olliebuckthorpe/inverted-pendulum/hardware/cad/LAYOUT.md

# Rig layout and CAD notes (PLAN 2.2)

Parametric CAD in `pendulum_cad.py` (CadQuery). `uv run python pendulum_cad.py` writes STEP + STL to `out/`;
`uv run python preview.py` renders `out/assembly_preview.png`. Change a number in `P`, re-run, re-print.

## Rig layout (decided 25 Sep: desk-edge beam)

- The rail is bolted to the **front face of a stiff beam** (e.g. 1.2 m of 18 mm plywood on edge) that is
  G-clamped along the **front edge of the desk**. The rods hang over the edge: the single needs 30 cm below
  the pivot and the double (both hanging) 50 cm; a ~72 cm desk clears both.
- The pendulum shaft comes straight out of the cart toward the room; **the rod swings in the frontmost plane
  of the rig** (Y ≈ 47 mm). Nothing else may be in front of Y ≈ 40 mm anywhere the rods can reach: at the rail
  ends the double's rods sweep up to 50 cm around the pivot.
- **So the motor and idler sit behind that plane:** the motor body goes behind the beam (end blocks overhang
  the beam ends), with the pulley in the belt plane. The belt runs just below the rail, between the beam and
  the carriage (Y ≈ −9 … −3 mm).
- Safety: keep legs and hands out of the swing zone in front of the desk; the E-stop must be reachable
  without reaching past the rods.

## Coordinates

X along the rail, Z up, Y out of the beam toward the room. Y = −13 beam face (MGN12H H = 13 mm);
Y = 0 carriage top face; Z = 0 rail centreline; the shaft is at Z = +34 mm.

## Parts so far (v1, untested)

| Part | Size (mm) | Est. print | Notes |
|---|---|---|---|
| cart | 70 × 49 × 84 | ~28 g | Plate on 12 mm pads on the MGN12H's 20 × 20 M3 pattern (M3 × **20**: engages 3.0 of the 3.5 mm thread). Boss holds two 608s ~13 mm apart. Ridged ledge for the belt below the carriage |
| belt_clamp | 40 × 17 × 3 | ~2 g | Squeezes the upper belt strand against the ledge; 2 × M3 × 12 self-tapping |
| sensor_mount | 36 × 14 × 36 | ~3 g | On 4 posts behind the plate; AS5047P board behind it, chip through a 14 mm window; slots ±2 mm |
| magnet_cap | Ø11 × 12 | ~1 g | Push-fit on the shaft's back end; holds the magnet 3 mm off the steel shaft |
| rod_hub | 36 × 18 × 14 | ~3 g | Split clamp on the shaft + socket for the 8 mm tube, M3 pinch screws |

**Steel shaft: cut to 49 mm.** The script prints this and the sensor gap; both follow from the parameters.

**Estimated cart mass ≈ 145 g** (printed ~35 g + MGN12H 54 g + two 608s ~24 g + 49 mm of 8 mm steel ~19 g +
sensor board and screws ~13 g). The sim assumed 400 g, and the AI's domain randomisation (±15%) never reaches
145 g: update `sim/params.yaml` cart.mass before the final training (weigh the real parts in PLAN 2.2).

## Why some choices were made

- **Sensor behind the plate:** the front of the shaft carries the rod, which swings a full circle, so no
  bracket can reach the front end. The back end sits in free space above the carriage.
- **Magnet cap (precaution):** the shaft is silver steel, which is magnetic and may distort the magnet's
  field; the AS5047P datasheet doesn't cover shaft material. The cap holds the magnet 3 mm off the steel.
  Check in PLAN 2.4 (smooth 0–360° reading, noise); set `cap_spacer` to 0 if it proves unnecessary.
- **Taller pads (M3 × 20):** gives 10.7 mm behind the sensor bracket for the board and its pins.

## Check when the parts arrive (before printing the final version)

- [ ] AS5047P adapter board: outline, hole positions, thickness, chip height, and header direction
      (update `sensor_mount` if the ±2 mm slots don't cover it).
- [ ] **Print `out/fit_test.stl` first** (≈ 14 g, ~30–40 min): three 608 seats and three 8 mm shaft bores at
      radial clearance 0.10 / 0.15 / 0.20 mm, marked with 1 / 2 / 3 notches. Pick the tightest seat a bearing
      still presses into by hand and the tightest bore the shaft turns in; set `fit` in `P` (default 0.15 mm)
      and re-export before printing the cart, rod hub and magnet cap.
- [ ] Measure the GT2 belt thickness; tune `belt_t`.
- [ ] PLAN 2.2 "done when": the cart slides the full rail by hand without binding, the shaft spins freely in
      both bearings, the magnet sits centred on the sensor.

## End blocks and the safety stop (added 25 Sep)

| Part | Est. print | Notes |
|---|---|---|
| motor_block | ~17 g | +X end. Flange on the beam's end face + tab on its back face (4 wood screws). The Pololu 37D bolts to the plate's back, shaft through toward the room; **12 holes on the Ø31 circle** so the motor fits either hexagon orientation; **M3 screws may enter the gearbox only 3.0 mm** (Pololu drawing). Gearbox centre 7 mm outboard of the shaft; motor body behind the beam's plane, beyond its end |
| idler_block | ~20 g | −X end. Fork holding the 20T idler on an M5 bolt in 14 mm slots: pull outward to tension the belt, tighten; M3 push screw for fine adjustment |
| end_ramp_right / _left | ~33 g each | Foot on the beam face below both belt strands, arm forward under the cart, upright in front of the cart plate (Y 35–40, behind the rod at Y ≈ 43.5). The ramp rises 3 mm from X = ±350 and stays high to the bumper |
| switch_carrier | ~5 g | On the cart plate's front face below the boss: two roller micro switches in series, mirrored so the rollers sit at ±7 mm; slotted to set a 2 mm press |
| bumper_right / _left | ~2 g each | **Print in TPU.** Hollow blocks at X = ±480 in the carriage's path: the last resort |

**Why the end-stops ride on the cart:** a fixed end-stop hit head-on has ~2 mm of overtravel, but after tripping
the cart keeps braking for up to ~118 mm and would crush it. On the ramps, the rollers are pushed sideways
and **stay pressed** while the cart brakes; push the cart back by hand to reset. The switch wires join the
sensor cable to the cart.

**Checked by `clearance.py`** (cart at 0, ±325, ±340, ±355, ±457 mm; rod hanging, horizontal both ways,
upright): 0 collisions; switches released at ±325/±340 (the swing-ups use ≤ ±325), pressed at ±355 and
beyond, first trip ≈ ±348 mm. The only contacts are the intended ones (carriage on rail, grip ridges in
the belt teeth). Previews: `out/ends_preview.png`.

**Frame constraint:** the motor's underside is ~55 mm below the rail centre, so keep the beam's base / the
desk ≥ 60 mm below the rail centre in the motor zone. Beam clamps: ordinary G-clamps (nothing to print).

## Still to design

E-stop enclosure (depends on the switch bought), a guide for the cable to the cart.

⚠️ Measure on arrival: micro switch body, holes and lever height; 30T pulley hub; 20T idler width.

Sources: HIWIN MG-series catalogue (MGN12H: W 27, B 20, C 20, L 45.4, H 13, M3 × 3.5, 0.054 kg; MGN12 rail
WR 12, HR 8, P 25): https://hiwin.co.uk/wp-content/uploads/2017/05/CRD-Hiwin-Linear-guides-MG-series.pdf ·
Pololu #4757 dimensions: https://www.pololu.com/product/4757
