olliebuckthorpe/inverted-pendulum/hardware/cad/out/ends_preview.png

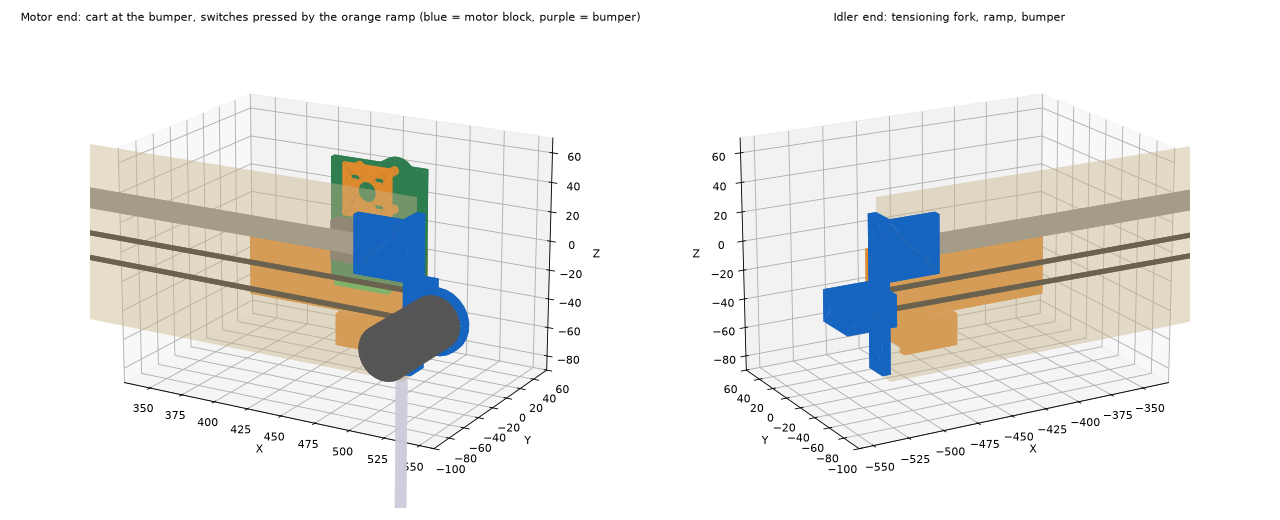
hardware/cad/out/ends_preview.png
