olliebuckthorpe/inverted-pendulum/sim/plots/1.2-fall-from-upright.png

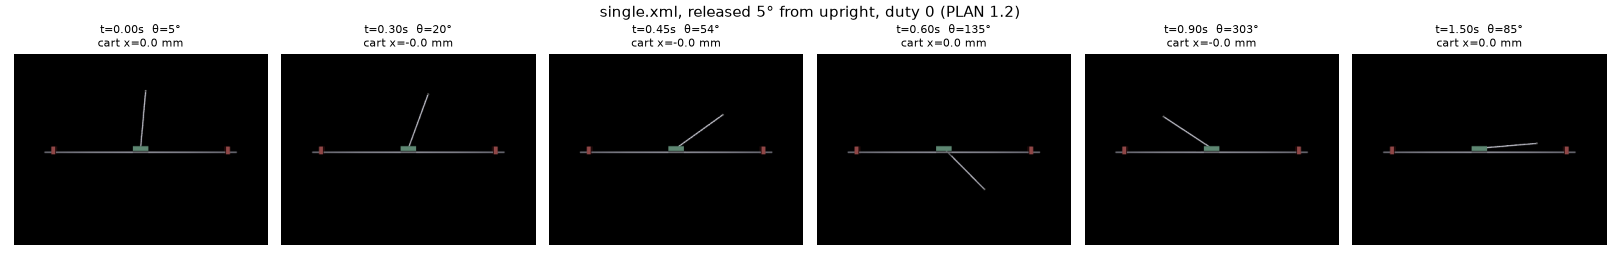
sim/plots/1.2-fall-from-upright.png
