olliebuckthorpe/inverted-pendulum/sim/plots/1.4-lqr-balance.png

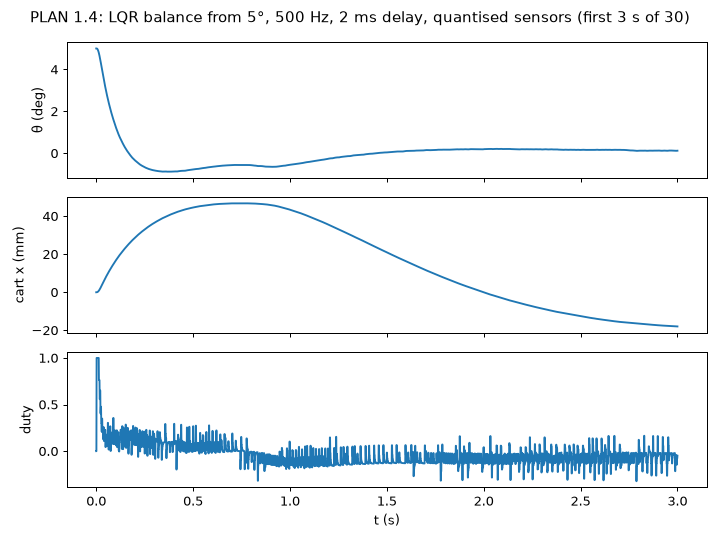
sim/plots/1.4-lqr-balance.png
