olliebuckthorpe/inverted-pendulum/sim/plots/1.5-swingup.png

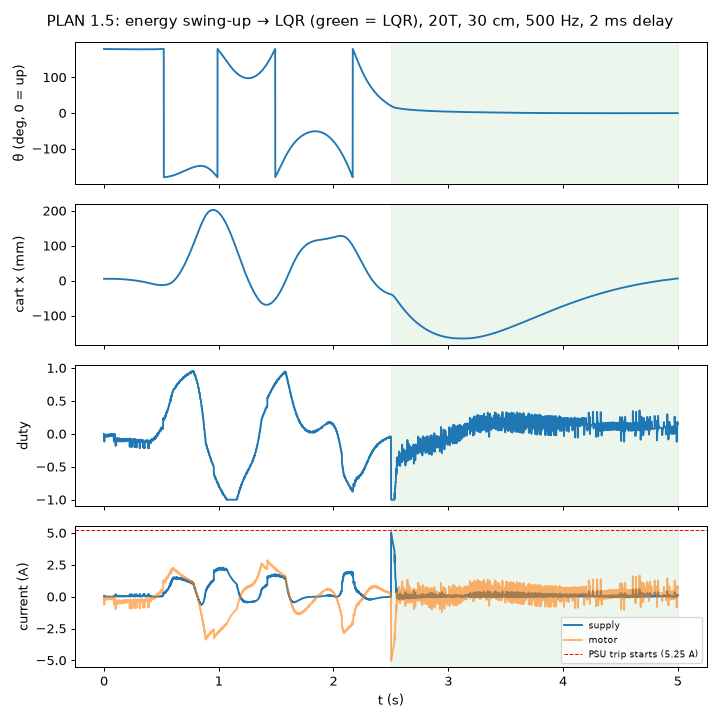
sim/plots/1.5-swingup.png
