olliebuckthorpe/inverted-pendulum/sim/plots/q2-swingup-20T-vs-30T.png

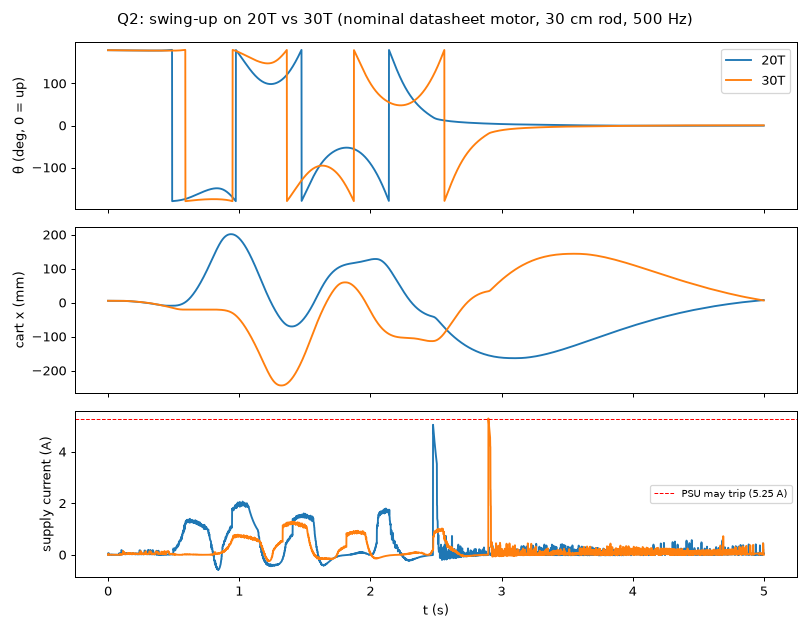
sim/plots/q2-swingup-20T-vs-30T.png
