olliebuckthorpe/inverted-pendulum/sim/plots/sim-phase-single-summary.png

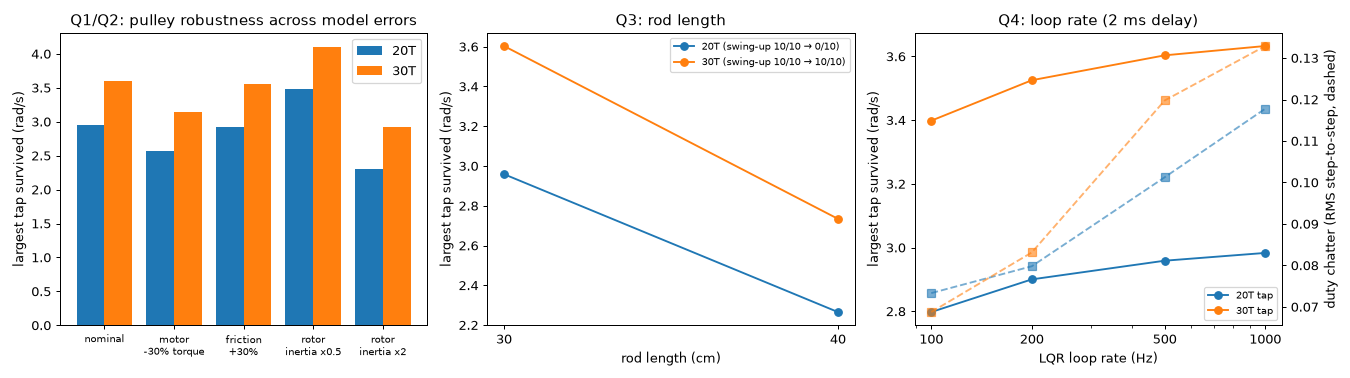
sim/plots/sim-phase-single-summary.png
