olliebuckthorpe/inverted-pendulum/hardware/cad/out/cart.step

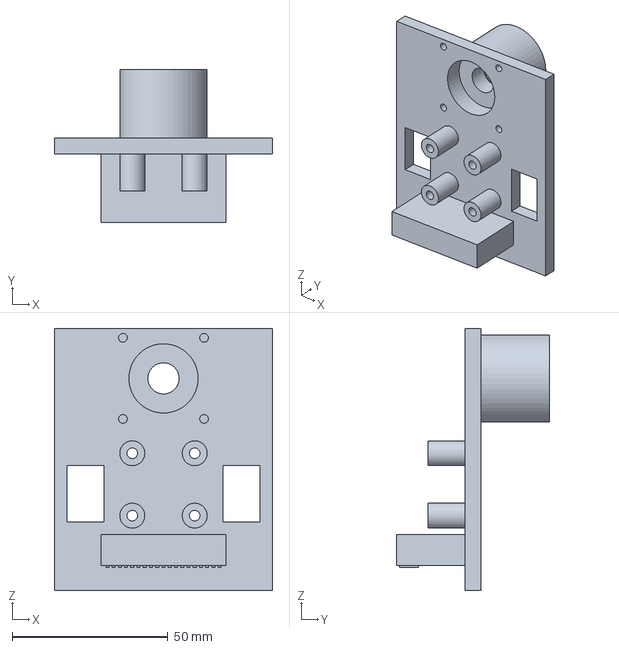
[picture p7: CAD file, 2026-10-05]
hardware/cad/out/cart.step
70.0 x 49.0 x 84.0 mm
