olliebuckthorpe/inverted-pendulum/hardware/cad/out/rod_hub.step

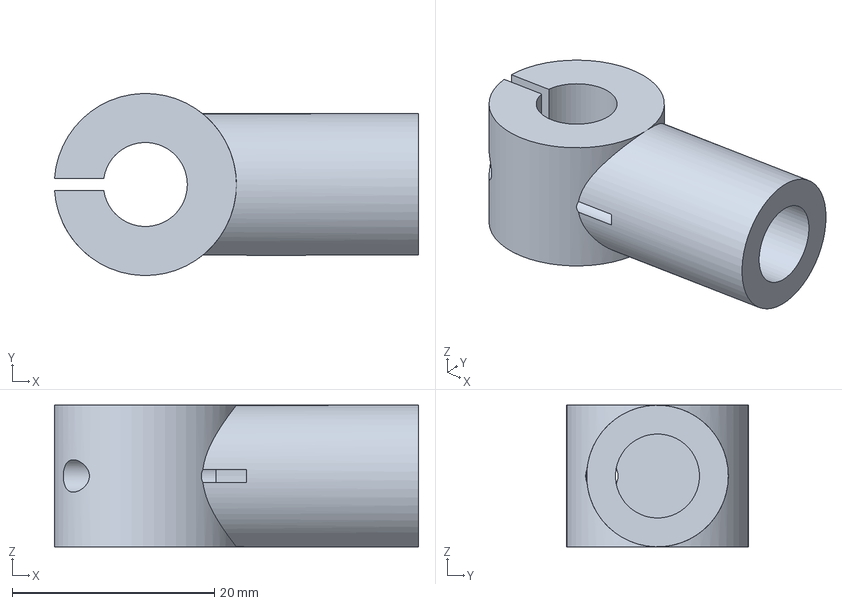
[picture p8: CAD file, 2026-10-05]
hardware/cad/out/rod_hub.step
36.0 x 18.0 x 14.0 mm
