olliebuckthorpe/inverted-pendulum/hardware/cad/out/magnet_cap.step

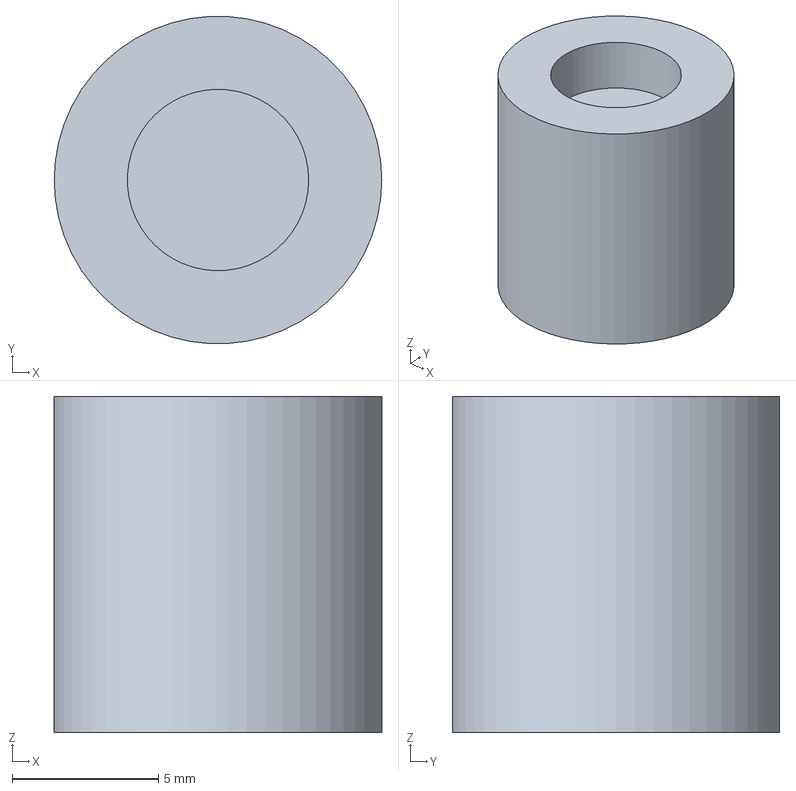
[picture p9: CAD file, 2026-10-05]
hardware/cad/out/magnet_cap.step
11.2 x 11.2 x 11.5 mm
