olliebuckthorpe/inverted-pendulum/hardware/cad/out/fit_test.step

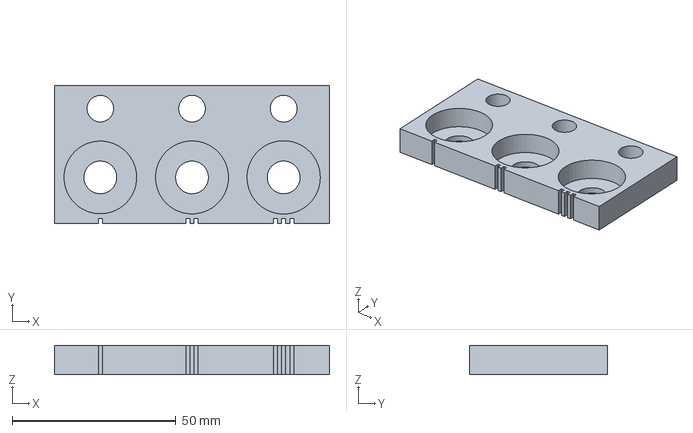
[picture p10: CAD file, 2026-10-05]
hardware/cad/out/fit_test.step
84.0 x 42.0 x 9.00 mm
