olliebuckthorpe/inverted-pendulum/hardware/cad/out/end_ramp_left.step

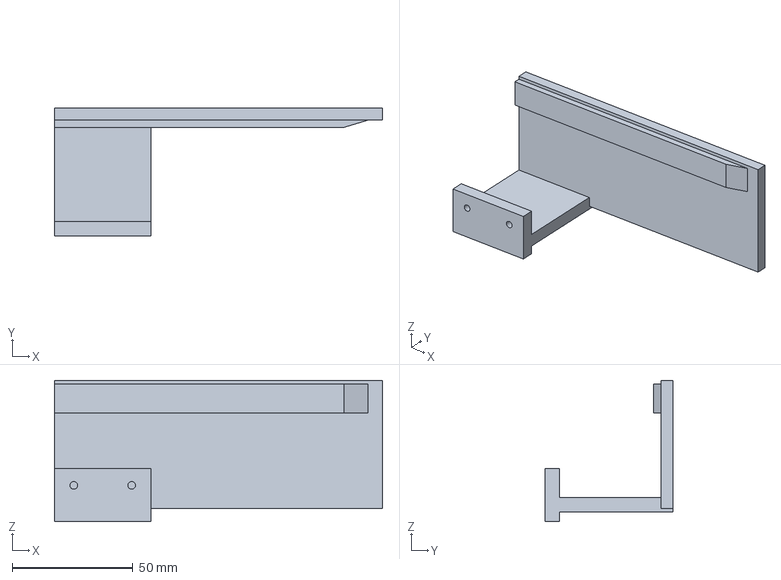
[picture p11: CAD file, 2026-09-25]
hardware/cad/out/end_ramp_left.step
136.0 x 53.0 x 58.5 mm
