olliebuckthorpe/inverted-pendulum/hardware/cad/out/bumper_right.step

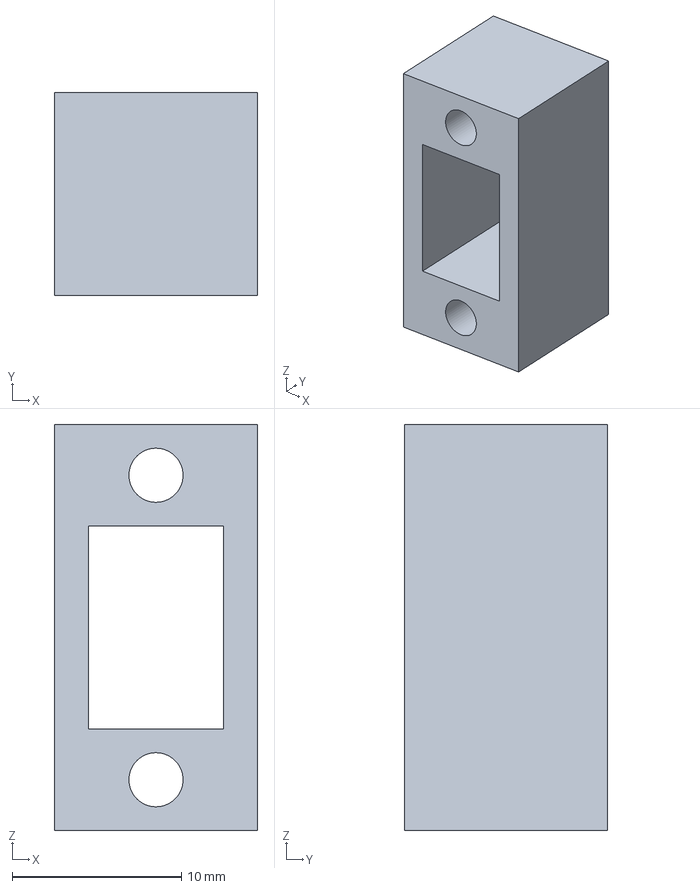
[picture p12: CAD file, 2026-09-25]
hardware/cad/out/bumper_right.step
12.0 x 12.0 x 24.0 mm
