olliebuckthorpe/inverted-pendulum/hardware/cad/out/switch_carrier.step

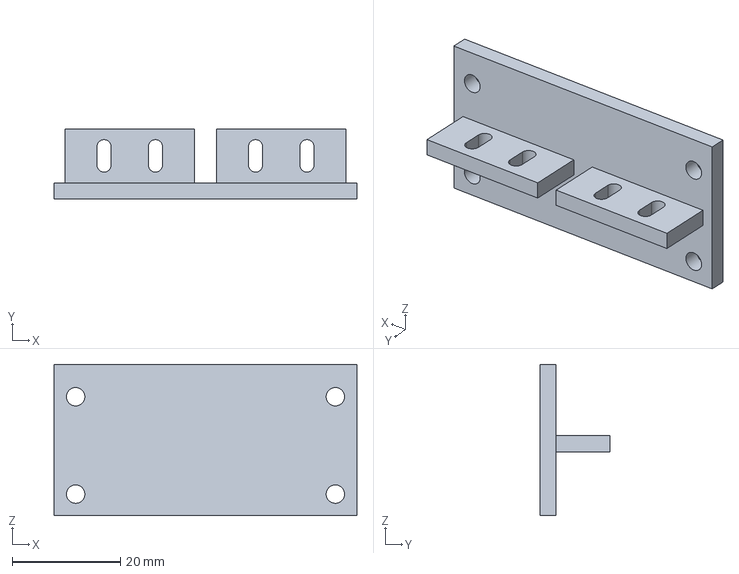
[picture p13: CAD file, 2026-09-25]
hardware/cad/out/switch_carrier.step
56.0 x 13.0 x 28.0 mm
