olliebuckthorpe/inverted-pendulum/hardware/cad/out/motor_block.step

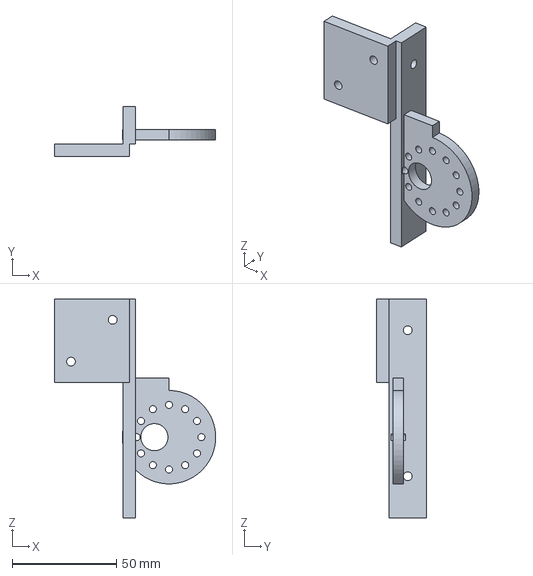
[picture p14: CAD file, 2026-09-25]
hardware/cad/out/motor_block.step
77.4 x 24.0 x 105.0 mm
