olliebuckthorpe/inverted-pendulum/hardware/cad/out/belt_clamp.step

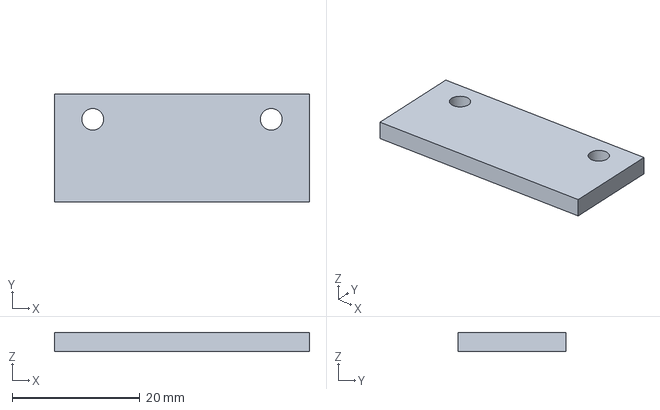
[picture p15: CAD file, 2026-09-25]
hardware/cad/out/belt_clamp.step
40.0 x 17.0 x 3.00 mm
