olliebuckthorpe/inverted-pendulum/hardware/cad/out/sensor_mount.step

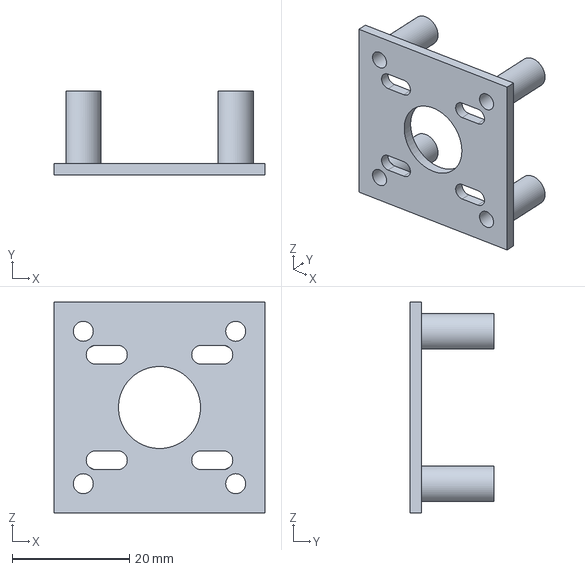
[picture p16: CAD file, 2026-09-25]
hardware/cad/out/sensor_mount.step
36.0 x 14.3 x 36.0 mm
