olliebuckthorpe/inverted-pendulum/hardware/cad/out/idler_block.step

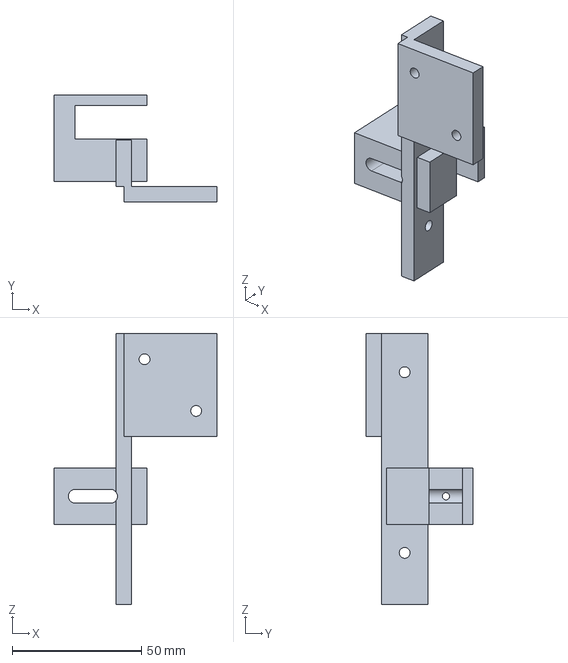
[picture p17: CAD file, 2026-09-25]
hardware/cad/out/idler_block.step
63.0 x 41.5 x 105.0 mm
