olliebuckthorpe/inverted-pendulum/(list of files, cad)

Other CAD files:
hardware/cad/out/cart_print.step
hardware/cad/out/bumper_left.step
hardware/cad/out/end_ramp_right.step
hardware/cad/out/belt_clamp.stl
hardware/cad/out/bumper_left.stl
hardware/cad/out/bumper_right.stl
hardware/cad/out/cart.stl
hardware/cad/out/cart_print.stl
hardware/cad/out/end_ramp_left.stl
hardware/cad/out/end_ramp_right.stl
hardware/cad/out/fit_test.stl
hardware/cad/out/idler_block.stl
hardware/cad/out/magnet_cap.stl
hardware/cad/out/motor_block.stl
hardware/cad/out/rod_hub.stl
hardware/cad/out/sensor_mount.stl
hardware/cad/out/switch_carrier.stl
