olliebuckthorpe/inverted-pendulum/hardware/cad/out/assembly_preview.png

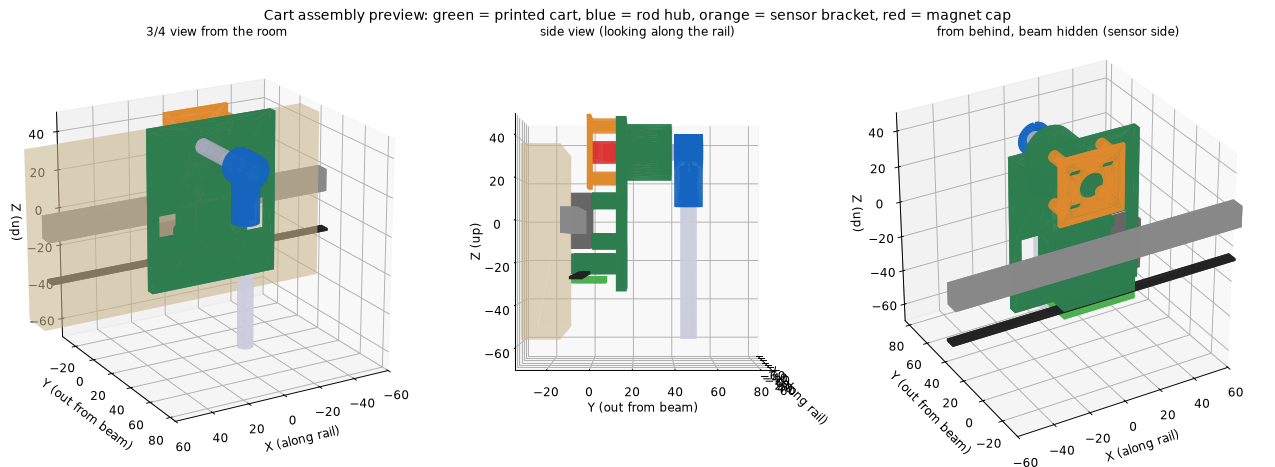
hardware/cad/out/assembly_preview.png
