olliebuckthorpe/inverted-pendulum/sim/RESULTS-sim-phase.md

# Sim phase results (PLAN 1.6), 24 Sep 2026

The sim is **built from datasheets plus guesses** (listed at the end). It can show that something clearly
won't work; it can't prove that something will (SPEC §11). Every number below will move after system ID
(Phase 4).

**Rig simulated:** MuJoCo at 1 kHz. The motor model comes from the Pololu 37D datasheet, including the rotor's
reflected inertia. There's a 2 ms control delay, quantised sensors (400-count motor encoder, 14-bit angle),
and velocities from filtered differencing, as the Pico will do. Code and tests are in `sim/`
(`uv run pytest`: 18 tests).

## Answers at a glance

| # | Question | Answer | Confidence |
|---|---|---|---|
| 1 | Is the Pololu 37D 6.3:1 12 V strong enough? | **Yes**: single swing-up 10/10 on both pulleys, including with 30% less torque, 30% more friction, and rotor inertia ×0.5 or ×2 | Good for "not clearly too weak"; hardware must confirm |
| 2 | 20T or 30T pulley? | **30T (chosen by Ollie, 24 Sep)**: +22% bigger tap survived, better in every model-error case, faster swing-up | Good; driven by rotor inertia, which is estimated |
| 3 | 30 cm or 40 cm rod? | **Keep 30 cm**: 40 cm is worse on both pulleys, and on 20T it can't swing up at all | Good |
| 4 | Loop rate? | **500 Hz for the single** (1 kHz gains ≤ 3% but doubles command chatter); **1 kHz available for the double's swing-up** (more tracking margin) | Medium: depends on the real delay and sensor noise |
| 5 | Double layout? | **30 cm aluminium bottom (rod 1) + 20 cm carbon top**; swing-up 10/10 at 500 Hz and 1 kHz in sim | Medium: very sensitive to the double's own masses and friction |
| 6 | Is the 12 V 5 A PSU enough? | **Yes, with a firmware current limit**: every swing-up, single and double, still succeeds with the supply capped at 5 A | Medium: the limiter needs the fitted motor constants |

**To order now (Ollie):** Pololu 37D 6.3:1 12 V with 64 CPR encoder (#4757), and the Mean Well GST60A12-P1J
from RS. Both pulleys are already on the list.

---

## 1. Motor adequacy

Energy swing-up → LQR, 10 randomised starts per case, 500 Hz, 2 ms delay (`q2_pulley.py`):

| World | 20T swing-up | 30T swing-up |
|---|---|---|
| Datasheet (nominal) | 10/10 | 10/10 |
| Motor −30% torque | 10/10 | 10/10 |
| Friction +30% | 10/10 | 10/10 |
| Rotor inertia ×0.5 | 10/10 | 10/10 |
| Rotor inertia ×2 | 10/10 | 10/10 |

The fallback (the 24 V motor) is not needed on this evidence.

## 2. Pulley: 30T (chosen)

Plot: `plots/sim-phase-single-summary.png` (left); swing-up traces: `plots/q2-swingup-20T-vs-30T.png`.

| | 20T | 30T |
|---|---|---|
| Largest tap LQR survives, nominal | 2.96 rad/s | **3.60 rad/s** |
| … with motor −30% | 2.57 | **3.14** |
| … with rotor inertia ×2 | 2.30 | **2.92** |
| Swing-up time when allowed to push harder (a_max 10 m/s²) | 2.34 s | **1.68 s** |
| Share of swing-up at full duty | up to 29% | 11–18% |
| Rail used (of ±400 mm) | ≤ 250 mm | ≤ 325 mm |
| Cart resolution | 0.10 mm/count | 0.15 mm/count |

**Why the lower-force pulley wins:** the motor's rotor spins 6.3× faster than the gearbox output, so to the
cart it feels like extra mass of J·N²/r². That's **~2.9 kg on 20T but ~1.3 kg on 30T**, against a 0.4 kg
cart. The 30T's bigger radius cuts that phantom mass by 2.25×, which more than makes up for its 1.5× lower
force. The rotor inertia J isn't published; it's estimated from comparable motors, which is why it was swept
from ×0.5 to ×2. The 30T wins at every value.

**Costs of 30T:** it uses more rail during swing-up (75 mm margin left), a faster cart hits the end-stops
harder (relevant to the safety checklist), and the position resolution is slightly coarser (still well under
a millimetre).

## 3. Rod length: keep 30 cm

| | 30 cm | 40 cm |
|---|---|---|
| 30T: swing-up / largest tap | 10/10, 3.60 rad/s | 10/10, 2.73 rad/s |
| 20T: swing-up / largest tap | 10/10, 2.96 rad/s | **0/10** (runs into the rail), 2.27 rad/s |

A longer rod falls more slowly, but it needs more energy and more cart travel to swing up. (Caveat: the same
tap in rad/s is a slightly bigger push on a longer rod. The 20T/40 cm swing-up failure settles it anyway.)

## 4. Loop rate: 500 Hz

The single (LQR with a 2 ms delay):

| Rate | 30T largest tap | 20T largest tap | Swing-up | Command chatter (30T)* |
|---|---|---|---|---|
| 100 Hz | 3.40 | 2.80 | 10/10 | 0.069 |
| 200 Hz | 3.53 | 2.90 | 10/10 | 0.083 |
| 500 Hz | 3.60 | 2.96 | 10/10 | 0.120 |
| 1000 Hz | 3.63 | 2.98 | 10/10 | 0.133 |

\*RMS change in duty between consecutive commands while recovering from 5°. At higher rates, one sensor count
divided by a shorter time looks like a bigger velocity jump, so the motor gets buzzier.

The plan's rule is "the lowest rate that keeps full robustness, ×2 for margin". 200 Hz keeps 98% of the
robustness, so ×2 gives ~400 Hz; **500 Hz** is chosen (it's also the spec's default). For the double, balance is
equally good at both rates, but the swing-up has more margin at 1 kHz (§5), so keep the spec's ~1 kHz for the
double. The AI policy decides at 50–100 Hz as the spec says; that's a Phase 5 choice.

## 5. Double layout (balance and swing-up)

**Recommendation: bottom rod = the single's 30 cm aluminium rod, top rod = 20 cm carbon ("30/20").** It's the
only 30T layout whose swing-up tracks 10/10 at both 500 Hz and 1 kHz. It reuses rod 1, and its balance is
among the strongest.

All with the supply capped at 5 A, 10 randomised starts each (`q5_double.py`, `double_trajopt.py`):

| Layout (bottom/top, cm) | Balance: largest tap (rad/s) | Swing-up plan | Tracked 1 kHz | Tracked 500 Hz |
|---|---|---|---|---|
| **30T 30/20** | 0.88 | 2.46 s | **10/10** | **10/10** |
| 30T 30/30 | 0.74 | 2.05 s (planned within ±300 mm) | 10/10 | 9/10 |
| 30T 34/20 | 0.82 | 1.91 s (±300 mm) | 10/10 | 1/10 |
| 30T 20/30 | 0.87 | 1.88 s | 0/10 (runs into the rail) | 0/10 |
| 20T 30/20, 20T 34/20 | 0.84, 0.78 | none found | – | – |
| 20T 30/30, 20T 20/30 | 0.73, 0.91 | 2.54 s, 2.26 s | 10/10, 10/10 | 10/10, 10/10 |

The first plans were allowed to use ±350 mm of rail, and the fastest ones left the tracker no room to correct.
Re-planning within ±300 mm fixed two of the three.

**How much model error the 30T 30/20 swing-up tolerates** (planned on the nominal model, flown on a "wrong"
rig at 500 Hz, 5 randomised starts each):

| Survives (5/5) | Fails |
|---|---|
| cart mass ±20%, rotor inertia ×0.7, motor Kt −10%, rail friction ×2, 4 ms delay, 12-bit angles (0.09°) | rotor inertia ×1.4 (0/5), Kt −20% (0/5), joint-2 mass ±25% (1/5, 0/5), top-rod mass +20% (0/5), joint friction ×5 (0/5), **0.05° random angle noise** (0/5; balance survives it) |

So the hardware swing-up needs: **masses weighed** (easy, and they're the most sensitive), **motor constants and
joint friction from system ID**, a **low-friction** joint 1 (slip ring friction adds directly to joint
friction), and a **state estimator** (Kalman filter) rather than plain differencing, because the sensor noise
isn't measured yet (PLAN 2.4).

**Loop rate for the double:** balance is equally good at 500 Hz and 1 kHz. Swing-up tracking has more margin
at 1 kHz (34/20 only works there), so **the firmware should support 1 kHz for the double**; the single stays at
500 Hz.

## 6. Power supply: keep the 5 A unit, add a firmware current limit

- Uncapped, a single swing-up peaks at **5.1 A (20T) / 5.5 A (30T)** from the supply, and up to 7 A when the
  controller pushes harder. The double's tracking corrections reach **9.6 A**. The GST60A12 trips into hiccup
  mode at 105–150% of 60 W (≈ 5.25–7.5 A), so **an unprotected rig would sometimes drop out mid-swing**.
- With the supply current **capped at 5 A in software**, every swing-up still succeeds: the single on both
  pulleys (10/10), and the double on its working layouts (10/10). RMS current is only ~0.4–1.1 A, so the PSU
  isn't working hard on average.
- **Firmware requirement (for Phase 2.6 / 3.4):** port `motor.cap_duty_for_supply` to the Pico. From the duty
  cycle and the measured cart speed, it limits the duty so that supply current = duty × (V·duty − Ke·ω)/R stays
  ≤ the limit. Both controllers go through it, so the comparison stays fair. **Use 4.5 A until Phase 4 fits
  the real R and Ke**, then 5.0 A.
- Keep the 7.5 A fuse. The bulk capacitor for regenerative braking (PLAN 2.1) also absorbs millisecond
  peaks.

## Double swing-up (added at Ollie's request, 24 Sep)

Classical method: **trajectory optimisation** (CasADi + IPOPT, direct collocation) finds a motor-command plan
from both-hanging to both-upright, within duty ≤ 0.8, cart ≤ ±350 mm and supply ≤ 5 A. **Time-varying LQR**
then follows the plan and **hands over** to the double's balance LQR at the top. The equations of motion
were derived by hand (sympy/Lagrange) and match MuJoCo to 1 part in a million (`tests/test_double_eom.py`).
Video: `videos/double-30T_30-20-seed0.mp4` (regenerate with `uv run python watch.py double --video`).

**What this does and doesn't show:**
- It shows that **the motor, rail and 5 A supply are physically enough** for a double swing-up, and that a
  classical controller can follow a plan and hand over to balance despite delay, quantisation and unmodelled
  friction.
- It's **one rehearsed path**. A start far from hanging-still, or a push mid-swing, will probably fail. An AI
  policy could be more forgiving here, and that would make a genuine comparison.
- **Hardware:** no hobby build has been found that achieved it. Hackaday #12827 (a DC servo, 1.5 m rail, slip
  ring) only did it in simulation (last log, Nov 2019). It also needs the joint-2 sensor's signal to cross a
  spinning joint 1: a slip ring (capsule rings have no published torque or noise figures, and SPI through
  brushes is unproven; the AS5047P's ABI output or a local UART link would be more robust) or wireless
  (ESP-NOW ~5–25 ms latency, no pendulum precedent found). **Ollie decided to attempt it on hardware (SPEC §3);
  the signal path is still to choose.**

---

## Will the sensors on the order do the job? (checked 24 Sep)

AS5047P datasheet (v1-00, System Specifications): **RMS output noise 0.068° (1σ, typical, "not tested,
guaranteed by design")**; turning dynamic angle error compensation off (DAECDIS, meant for < 100 rpm) saves
0.016°; the sensor refreshes every ~0.22 µs; SPI runs up to 10 MHz; the ABI output is up to 4096 steps/rev
with programmable hysteresis (0–3 counts at 11-bit). Simulated at those noise levels:

| Job | Result at the datasheet noise (0.068°) | What it needs |
|---|---|---|
| Single: swing-up + balance | 10/10, largest tap 3.52 rad/s (vs 3.60 noise-free); fine even at 0.1° | Nothing extra |
| Double: balance | 5/5 at 500 Hz; **0/5 at 1 kHz** (differencing noise doubles) | Run double balance at 500 Hz, or use a better estimator |
| Double: swing-up | **0/5** at 0.068°, 0.052° and 0.034° with plain differencing | **Solved with a Kalman filter: 10/10 at 0.068°** (see the next section) |

**Ways to get the double swing-up to ≈ 0.02°:** (1) read the angle ~16 times per control cycle over SPI and
average; that cuts noise 4× **if** the noise is independent between reads, which the datasheet doesn't say,
so PLAN 2.4 must measure it; (2) replace plain differencing with a Kalman-filter state estimator, which uses
the model to reject noise (not yet built or tested). The single needs neither.

The motor encoder (64 CPR × 6.3 = 403 counts/rev → 0.15 mm on 30T) is already modelled in every run above,
and the end-stops only carry relay-coil current, so neither needs changing.

## Making the double swing-up work with the ordered sensors (24 Sep, later)

Everything below uses the AS5047P datasheet noise (0.068° RMS) and the 5 A supply limit, at 500 Hz.

1. **Where it failed:** during the swing-up, not at the hand-over. Differenced velocities are so noisy that
   the motor spent 64% of the swing-up at full duty (28% noise-free), lost the plan by 20–30°, and ran into
   the rail.
2. **Fix 1, a Kalman filter** (`double_control.kalman_gains`, `SwingUpThenBalanceKF`): it estimates all six
   states from the three position readings using the model and the command actually sent. Gains are
   precomputed along the plan, so it's cheap on a Pico. Result: **10/10 at 0.068°, 10/10 at 0.10°, 8/10 at
   0.15°** (differencing: 0/10 at all three). Full-duty time fell to 8–10%.
3. **What was left: model error.** One parameter at a time at its expected post-system-ID error, only
   **joint-2 friction** mattered: +15% OK, +20% fails, −50% OK. A 15 g top rod loses a large share of its
   energy to a tiny extra drag.
4. **Fix 2, plan gently and against extra friction** (`plan_variant.py`): duty ≤ 0.6, cart ±300 mm, joint-2
   friction assumed ×1.5. Monte Carlo over random rigs with **every** parameter wrong at once
   (`double_montecarlo.py`; masses ±2%, Kt ±10%, rotor ±15%, frictions ±30%, delay 1–4 ms):

| Plan | Post-sysid errors (50 rigs) | ×1.5 errors | ×2 errors |
|---|---|---|---|
| Original (duty 0.8, ±350 mm) | 19/30 | 16/30 | – |
| Gentle (duty 0.6, ±300 mm) | 45/50 | 37/50 | – |
| Friction margin ×1.3 only | 43/50 | 35/50 | – |
| **Gentle + joint-2 friction ×1.3** | **50/50** | **50/50** | 48/50 |
| **Gentle + joint-2 friction ×1.5 (chosen)** | **50/50** | **50/50** | 48/50 |

   The chosen plan also survives every large single error that broke the original (rotor ×1.4, Kt −20%,
   joint-2 mass ±25%, top rod +20%), a 4 ms delay, starts up to ±11° off hanging, 1 kHz (30/30), and joint
   friction on both joints from ×0.5 to ×1.5 (×2: 2/5).
5. **How to get the joint-2 signal across joint 1: a cable loop, no slip ring.**
   - Rod 1 **never needs to spin continuously**: in the plan and 20 flights on random rigs it stays within
     −6°…251° (at most half a turn from hanging). After a fall the motor is off, and a falling double can't
     gain the energy to go over the top again.
   - **Slip ring rejected:** the swing-up tolerates ≤ 2 mN·m of dry drag at joint 1 (fails at 4 mN·m), and
     SenRing's capsule rings are specified at 0.05 N·m (+0.01 N·m per 6 circuits).
   - **Cable loop:** tolerates a twist stiffness **≤ 0.5 mN·m/rad** if unmodelled (fails at 1.0).
     Back-of-envelope: 6 solid 30 AWG copper wires over a 10 cm bend ≈ 1.4 mN·m/rad (too stiff), so use
     fine-stranded silicone wire in a longer loop, and measure it (PLAN 2.5b). A stiffer cable can instead be
     measured and added to the model (a smooth spring, easy to model, unlike friction).
   - **Wireless** (kept as a fallback): tolerates the joint-2 reading being ≤ 6 ms late (fails at 10 ms).
     ESP-NOW is around that edge.

Video: `videos/double-30T_30-20_damping150_u60_x30-seed0.mp4` (noise, Kalman filter, 5 A limit), or live:
`./watch.sh double`.

## Transitions between all four resting positions (24 Sep, at Ollie's request)

The double has four resting positions (bottom rod first): **DD** both hanging (stable), **UU** both up,
**UD** rod 1 up with rod 2 hanging off its top, **DU** rod 1 hanging with rod 2 standing on its bottom end.
The last three have to be balanced.

- **Balance:** all three unstable positions are controllable (rank 6/6) and hold 5/5 for 20 s at datasheet
  noise with the Kalman filter. DU with plain differencing managed only 2/5.
- **All 12 transitions planned** (`plan_transition.py`: duty ≤ 0.6, cart ±300 mm, joint-2 friction ×1.5,
  rod 1 within ±1 turn of hanging for the cable) and flown with TVLQR + Kalman filter (`fly_transitions.py`).
  (Times below are for the 0.40 kg cart; re-planned for 0.16 kg on 30 Sep, same success, see the cart mass
  section.)

| From → to | Time | Nominal rig | Random post-sysid rigs |
|---|---|---|---|
| DD→UU (swing-up) | 2.21 s | 5/5 | 20/20 |
| DD→UD | 2.75 s | 5/5 | 20/20 |
| DD→DU | 1.35 s | 5/5 | 20/20 |
| UU→UD | 1.38 s | 5/5 | 20/20 |
| UU→DU | 2.10 s | 5/5 | 20/20 |
| UU→DD | 1.93 s | 5/5 | 20/20 |
| UD→UU | 1.37 s | 5/5 | 20/20 |
| UD→DU | 1.74 s | 5/5 | 20/20 |
| UD→DD | 1.70 s | 5/5 | 20/20 |
| DU→UU | 1.96 s | 5/5 | 17/20 (uses the full ±300 mm) |
| DU→UD | 1.69 s | 5/5 | 20/20 |
| DU→DD | 1.24 s | 5/5 | 20/20 |

- **Tours** (`double_control.tour`, holding each position 2 s): **DD→UU→UD→DU→DD** 5/5 nominal, 10/10 random
  rigs; **DD→UU→DU→UD→UU→DD** 5/5 nominal, 9/10 random rigs. Video:
  `videos/tour-DD-UU-UD-DU-DD-seed0.mp4`; live: `./watch.sh tour --legs DD,UU,UD,DU,DD`.
- **Design constraint found:** UD and DU need rod 2 to swing *past* rod 1, so joint 2 must carry rod 2
  beside rod 1 (the model offsets it 15 mm sideways), not in line with it.
- **Precedent:** Graichen, Treuer & Zeitz (Automatica 43, 2007) swung up a double pendulum on a cart on real
  hardware with planned feedforward plus linear feedback, framing it as a transition between equilibria.
  Whether they demonstrated every transition on hardware isn't confirmed here.

## Clone motor check (29 Sep, while ordering, at Ollie's request)

Question: could a ~£12–20 **JGB37-520** gearmotor with Hall encoder replace the Pololu #4757 (~£82 delivered)?
Modelled from seller figures only (no datasheet): 2.3 A stall at 12 V (so R ≈ 5.2 Ω), 0.15 A no-load,
Kt = Ke from the no-load speed. Everything else as the datasheet sim (30T, 5 A limiter at 4.5 A for the single,
sensor noise, slew). Scripts: `clone_motor_single.py`, `clone_motor_double.py`, `clone_motor_replan.py`.

| Motor (output shaft) | Stall torque | Single swing-up (20 starts) | Double, Pololu-planned trajectory (50 rigs) | Double, re-planned for this motor (50 rigs) |
|---|---|---|---|---|
| **Pololu #4757**, 1600 rpm | 0.294 N·m | 20/20, median 2.2 s | **50/50** | – |
| JGB37-520, 1000 rpm | 0.246 N·m | 20/20, median 2.2 s | 1/50 | u ≤ 0.6: **no feasible plan**; u ≤ 0.8: plan found (2.56 s) but **4/50** |
| JGB37-520, 1600 rpm | 0.154 N·m | 20/20, median 2.3 s | 1/50 | **no feasible plan** at u ≤ 0.6 or 0.8 |

- **The single swing-up needs far less than either motor has**, so a clone would do the single.
- **The double swing-up does not survive the clone**, even re-planned for its torque: the planner either finds
  no swing-up inside the rail and duty limits or one that leaves the tracker no authority (4/50).
- (The kick ladder isn't comparable across motors: a "duty = +1 for D ms" kick is weaker on a weaker motor.)
- **Decision (Ollie, 29 Sep): Pololu #4757 from TME**, because the double swing-up on hardware is in scope.
  The clone's figures are unverified seller numbers, which only strengthens that.

## Cart mass re-check: 0.16 kg instead of the 0.40 kg guess (30 Sep)

The CAD puts the cart at ≈ 145 g (hardware/cad/LAYOUT.md); with the moving belt and the end-stop switches,
carrier and cable, `params.yaml` now says **0.16 kg** (was a 0.40 kg guess). Every sim-phase decision re-run:

| Check | 0.40 kg (before) | 0.16 kg (now) |
|---|---|---|
| Single swing-up, 20 starts (Pololu, noise, 4.5 A cap) | 20/20 | 20/20, median 2.3 s |
| Q2 pulley: 30T vs 20T, largest tap survived | 30T +22 % | 3.77 vs 3.03 rad/s: 30T +24 %, every model-error case 10/10 |
| Q3 rod: 30 cm vs 40 cm (30T) | 30 cm | 30 cm (40 cm uses 315 mm of travel) |
| Q4 loop rate | 500 Hz | 500 Hz (tap 3.77 rad/s; 1 kHz adds 1 %) |
| Double swing-up, chosen gentle plan (re-planned) | 50 / 50 / 48 of 50 | **2.09 s; 50 / 50 / 50 of 50** at post-sysid errors ×0.5 / ×1 / ×1.5 |
| 12 transitions (re-planned), random post-sysid rigs | 11 × 20/20, DU→UU 17/20 | the same: 11 × 20/20, DU→UU 17/20; every one 5/5 nominal |

**Every decision stands; the lighter cart is slightly easier.** Trajectories in `results/trajectories/` are
re-planned for 0.16 kg (the old ones would be mis-scaled). The tours weren't re-run. Weigh the real parts in
PLAN 2.2 / BRINGUP stage 0 and replace 0.16.

## Numbers that are guesses (replace in Phase 4)

| Parameter | Value used | Why it matters |
|---|---|---|
| Motor rotor inertia | 3.0e-6 kg·m² (swept 1.5–6e-6) | Decides the pulley answer; measure it from voltage-step responses |
| Cart mass | 0.40 kg | Weigh the printed cart |
| Rail + belt friction | 1.0 N Coulomb, 0.5 N·s/m viscous | Triangle-wave system ID |
| Joint-2 hardware mass | 0.020 kg | Weigh it; it sets the double's dynamics |
| Joint damping | 2e-4 / 1e-4 N·m·s/rad | Free-swing decay |
| Backlash | 1° at the output | Direction-reversal test |
| Control delay | 2 ms | Measure the loop (PLAN 2.5/2.6) |
| Angle-sensor noise | 0 (quantisation only) | PLAN 2.4 |

## Changes made to SPEC/PLAN during the sim phase

- **End-stops switch a relay coil** instead of carrying motor current: micro switches have no usable DC power
  rating (Omron V-15: 0.6 A at 125 V DC). Items 15a/15b were added.
- **The PSU is ordered with the motor**, sized by Q6 (above: keep the 5 A unit).
- **The motor current is not clamped at 5.5 A in the model**: a reversal at speed really draws ~10 A.
- **Rotor inertia is modelled** (PLAN 1.3 had a placeholder of 0, which made the sim badly optimistic).
- **Double swing-up in sim is in scope**; on hardware it's an open decision.
