olliebuckthorpe/inverted-pendulum/sim/results/ai_double/double_balanceEb50_seed0.monitor.csv

#{"t_start": 1790772329.687628 | "env_id": "None"}
r | l | t
-6.724832 | 18 | 0.684773
-11.40052 | 13 | 0.69161
-7.345934 | 17 | 0.699745
-8.679571 | 16 | 0.70735
-7.688312 | 16 | 0.715104
-7.186019 | 17 | 0.723091
-13.030351 | 11 | 0.728696
-10.168413 | 15 | 0.735905
-7.106801 | 19 | 0.747974
-5.551771 | 20 | 0.757803
-8.921258 | 15 | 0.765315
-12.206494 | 12 | 0.77216
-3.91115 | 21 | 0.782446
-6.50631 | 19 | 0.791558
-0.516672 | 25 | 0.803149
-8.760808 | 17 | 0.811441
-11.559556 | 14 | 0.81929
-7.065719 | 19 | 0.828531
-9.576327 | 15 | 0.836081
-10.724851 | 13 | 0.84266
-0.042068 | 24 | 0.8538
-2.60914 | 22 | 0.863912
-7.625232 | 17 | 0.872332
-11.140396 | 15 | 0.879545
-11.943064 | 12 | 0.885886
-4.828593 | 19 | 0.895059
-11.122367 | 14 | 0.902251
-10.320686 | 13 | 0.908767
-10.502342 | 14 | 0.915784
-5.01993 | 20 | 0.937687
-8.060994 | 16 | 0.954119
-10.565236 | 15 | 0.980202
3.172166 | 27 | 1.007941
-9.808438 | 16 | 1.027638
-11.895504 | 12 | 1.039824
-10.894214 | 13 | 1.061768
-8.908122 | 15 | 1.069643
-4.799617 | 20 | 1.079419
-5.767945 | 18 | 1.09359
-6.083782 | 21 | 1.120484
-8.508284 | 16 | 1.134788
-10.326724 | 14 | 1.150238
4.638612 | 31 | 1.175469
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
