olliebuckthorpe/inverted-pendulum/sim/results/ai_double/double_balanceEb50_seed1.monitor.csv

#{"t_start": 1790772329.688731 | "env_id": "None"}
r | l | t
-7.94808 | 16 | 0.782111
-6.634444 | 17 | 0.811132
-4.110221 | 22 | 0.838788
-10.657135 | 14 | 0.863478
-10.92468 | 15 | 0.892997
-2.636256 | 27 | 0.936911
-5.489354 | 19 | 0.96082
-12.979179 | 13 | 0.975113
-3.644293 | 22 | 1.010639
-8.057813 | 16 | 1.021029
0.819032 | 25 | 1.040304
1.366726 | 26 | 1.078656
-14.424427 | 12 | 1.099959
-10.554315 | 14 | 1.125821
-2.540107 | 23 | 1.15399
-5.759105 | 19 | 1.171815
-6.526598 | 18 | 1.18035
-13.036692 | 11 | 1.187652
-7.767392 | 16 | 1.200128
4.653952 | 33 | 1.221954
-11.111234 | 13 | 1.228854
-8.090444 | 17 | 1.259054
-6.195476 | 19 | 1.270224
-11.107339 | 12 | 1.276808
-10.659877 | 13 | 1.286508
-8.821019 | 15 | 1.312764
-10.782715 | 14 | 1.32072
-11.102801 | 16 | 1.332049
-9.160673 | 15 | 1.361884
-4.125042 | 19 | 1.401538
-9.111448 | 15 | 1.411751
-8.858932 | 15 | 1.423635
-12.429373 | 12 | 1.429606
-9.670443 | 15 | 1.436786
-7.81538 | 16 | 1.44465
-11.548238 | 14 | 1.451699
-2.167844 | 22 | 1.461809
-3.489466 | 21 | 1.473996
-10.351992 | 15 | 1.490306
-7.434815 | 17 | 1.498265
-7.583539 | 17 | 1.506328
-3.456973 | 21 | 1.516274
-7.87417 | 16 | 1.531146
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
