olliebuckthorpe/inverted-pendulum/sim/results/ai_double/double_balanceEb_seed0.monitor.csv

#{"t_start": 1790768243.503079 | "env_id": "None"}
r | l | t
69.707008 | 114 | 0.956505
45.417892 | 86 | 0.971757
41.136626 | 78 | 0.993955
57.156412 | 102 | 1.027935
33.199247 | 67 | 1.048555
36.669901 | 70 | 1.074475
51.78831 | 90 | 1.106974
42.789457 | 78 | 1.126109
47.746678 | 84 | 1.159633
32.499655 | 66 | 1.176116
48.55324 | 88 | 1.203808
83.882522 | 132 | 1.233314
44.139101 | 81 | 1.24838
38.856325 | 74 | 1.260722
80.881845 | 122 | 1.321518
29.628404 | 75 | 1.371834
38.63175 | 75 | 1.38488
54.46912 | 96 | 1.470799
70.275583 | 107 | 1.51387
45.686969 | 80 | 1.555659
60.663801 | 98 | 1.581948
40.714825 | 76 | 1.595988
40.264261 | 82 | 1.622112
50.933472 | 92 | 1.64068
33.969716 | 72 | 1.664549
53.370145 | 89 | 1.688729
33.05812 | 72 | 1.702995
26.470954 | 62 | 1.72157
31.901781 | 66 | 1.741447
41.474191 | 79 | 1.764924
37.734919 | 72 | 1.791216
102.525145 | 159 | 1.835317
28.593781 | 68 | 1.854821
71.240122 | 117 | 1.912763
31.962127 | 66 | 1.923964
38.097732 | 73 | 1.94157
70.844501 | 111 | 1.98891
43.921799 | 82 | 2.056818
53.807958 | 89 | 2.11039
63.297626 | 101 | 2.135185
40.554961 | 80 | 2.15618
36.437896 | 72 | 2.179582
34.339648 | 78 | 2.197727
63.18292 | 106 | 2.23268
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
