olliebuckthorpe/inverted-pendulum/sim/results/ai_double/double_balanceEb_seed1.monitor.csv

#{"t_start": 1790768243.4981692 | "env_id": "None"}
r | l | t
34.338479 | 70 | 0.952001
50.574451 | 85 | 0.978049
61.08597 | 97 | 1.011014
53.955338 | 90 | 1.029216
58.411175 | 94 | 1.053957
51.063266 | 86 | 1.071512
43.075124 | 79 | 1.084999
40.704748 | 75 | 1.09745
42.91097 | 77 | 1.122706
34.933781 | 71 | 1.138251
138.253355 | 178 | 1.196483
65.225162 | 100 | 1.217255
33.364535 | 69 | 1.243945
64.521036 | 102 | 1.278602
46.970801 | 88 | 1.308539
55.933116 | 95 | 1.324664
59.806669 | 97 | 1.341024
58.730797 | 94 | 1.356801
59.487791 | 104 | 1.412962
89.548921 | 135 | 1.48532
57.883406 | 93 | 1.555317
73.164598 | 115 | 1.588413
44.164945 | 81 | 1.604192
36.702395 | 72 | 1.628393
62.209417 | 98 | 1.66079
44.58079 | 79 | 1.687383
74.049923 | 111 | 1.719719
50.191203 | 85 | 1.743867
52.083966 | 97 | 1.768078
35.497651 | 71 | 1.785501
27.542173 | 61 | 1.809375
43.041836 | 78 | 1.831145
38.119427 | 73 | 1.843739
33.231274 | 72 | 1.879557
86.483084 | 127 | 1.928127
43.8324 | 86 | 1.951376
37.098543 | 76 | 1.970028
35.958746 | 70 | 1.99811
54.567463 | 97 | 2.058513
44.370676 | 90 | 2.112798
33.006986 | 67 | 2.131159
55.750444 | 93 | 2.155197
30.453833 | 65 | 2.185652
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
