olliebuckthorpe/inverted-pendulum/sim/results/ai_double/double_balanceG50_seed0.monitor.csv

#{"t_start": 1790773697.605828 | "env_id": "None"}
r | l | t
-8.053891 | 16 | 0.791593
-7.768842 | 16 | 0.802227
-10.748187 | 13 | 0.809814
-9.229854 | 15 | 0.817849
-12.109917 | 13 | 0.826419
-12.562428 | 12 | 0.833943
-6.999359 | 18 | 0.843338
-10.29213 | 14 | 0.857299
-10.024892 | 16 | 0.866737
-11.264636 | 12 | 0.873232
-6.390919 | 18 | 0.883492
-3.223559 | 23 | 0.893939
-9.687787 | 14 | 0.90103
-3.14497 | 23 | 0.911333
-6.064639 | 18 | 0.919577
-13.626033 | 11 | 0.926077
-12.866287 | 13 | 0.935822
-9.277454 | 15 | 0.943621
-0.162823 | 27 | 0.95602
-7.616859 | 16 | 0.965069
-8.18972 | 16 | 0.974058
-10.880555 | 13 | 0.981518
0.464051 | 25 | 0.994044
-12.737506 | 13 | 1.001974
-12.503625 | 12 | 1.009207
-11.142606 | 13 | 1.015942
-11.465829 | 13 | 1.022395
-4.552934 | 19 | 1.031428
-2.876165 | 21 | 1.042219
-4.27126 | 20 | 1.052819
-4.670549 | 19 | 1.062283
-12.791813 | 12 | 1.068384
-9.979483 | 14 | 1.075741
-9.467839 | 16 | 1.084275
-4.440141 | 23 | 1.095456
-7.586811 | 17 | 1.106577
-9.369349 | 15 | 1.119314
-6.340037 | 20 | 1.129777
-1.248882 | 23 | 1.14177
-11.222694 | 13 | 1.149568
-7.921911 | 16 | 1.159457
-0.464881 | 25 | 1.172554
-1.632645 | 25 | 1.189724
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
