olliebuckthorpe/inverted-pendulum/sim/results/ai_double/double_balanceG50_seed1.monitor.csv

#{"t_start": 1790773697.605839 | "env_id": "None"}
r | l | t
-10.227168 | 16 | 0.790391
-6.204811 | 18 | 0.799759
-4.821137 | 20 | 0.809318
-5.288609 | 20 | 0.818989
-3.924576 | 20 | 0.828791
-5.422201 | 20 | 0.842584
-7.96047 | 15 | 0.849836
-9.101772 | 16 | 0.857291
-4.971903 | 22 | 0.87044
-8.974579 | 15 | 0.87824
-10.12368 | 15 | 0.885357
-5.507808 | 18 | 0.894314
-8.938376 | 16 | 0.903383
-12.070654 | 12 | 0.910171
-7.480176 | 17 | 0.919215
-8.509991 | 15 | 0.927315
-9.702404 | 14 | 0.935431
4.478097 | 31 | 0.950664
-13.22017 | 12 | 0.956686
-8.332096 | 15 | 0.964826
-8.517934 | 16 | 0.974142
4.180522 | 31 | 0.989547
-5.990817 | 18 | 0.999491
-3.50593 | 20 | 1.011063
-9.922327 | 14 | 1.01801
-7.952972 | 16 | 1.025984
-11.86927 | 12 | 1.033332
-10.669484 | 13 | 1.040476
-9.352915 | 15 | 1.048356
-10.243065 | 14 | 1.055467
-10.320428 | 13 | 1.061888
-11.835242 | 14 | 1.069326
-4.317224 | 20 | 1.080471
-8.434013 | 15 | 1.088519
-11.023026 | 14 | 1.097591
-11.380163 | 14 | 1.106523
-6.529865 | 17 | 1.118484
-6.165795 | 18 | 1.128677
-5.328445 | 20 | 1.138457
-8.883821 | 16 | 1.146408
-9.822571 | 14 | 1.154015
-10.498825 | 15 | 1.161239
-8.744609 | 15 | 1.168511
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
