olliebuckthorpe/inverted-pendulum/sim/params.yaml

# Every physical number for the sim lives here (PLAN 1.2). System ID (Phase 4) overwrites these.
# Units are SI throughout: m, kg, s, N, V, A, rad.
# "source" notes say where each number came from; "guess" means a placeholder to be replaced by measurement.

supply:
  voltage: 12.0            # V. Mean Well GST60A12 (SPEC §6 item 9)
  current_cap: null        # A. null = unlimited. Set to 5.0 for SPEC §11 Q6 (does the 5 A PSU suffice?)

motor:                     # Pololu 37D 6.3:1 12 V #4757, all figures referred to the GEARBOX OUTPUT shaft
  R: 2.18                  # ohm. 12 V / 5.5 A stall current (datasheet)
  Kt: 0.0535               # N·m/A. 0.294 N·m stall torque / 5.5 A (datasheet)
  Ke: 0.069                # V·s/rad. (12 − 0.2 A·R) / 167.6 rad/s no-load speed (datasheet)
  I_noload: 0.2            # A. Datasheet no-load current: models gearbox friction as a constant drag torque
  gear_ratio: 6.3          # datasheet
  rotor_inertia: 3.0e-6    # kg·m² at the MOTOR shaft. Not published by Pololu. Estimate from comparable
                           # ~35 mm brushed motors (maxon RE 30 ≈ 3.4e-6, RE 35 ≈ 6.5e-6). Swept 1.5e-6–6e-6.
  backlash_deg: 1.0        # degrees of play at the output shaft. Pololu forum: "a couple of degrees";
                           # a customer measured ~1°. Used by the compliant-drive plant only.

drive:
  pulley_teeth: 30         # 30T chosen from the sim (SPEC §7, RESULTS-sim-phase.md §2). Radius = teeth × pitch / 2π
  belt_pitch: 0.002        # m. GT2
  belt_stiffness: 3.0e+4   # N/m. guess (GT2 6 mm over ~1 m). Only used by the compliant-drive plant
  belt_damping: 20.0       # N·s/m. guess

cart:
  mass: 0.16               # kg. CAD estimate 145 g (printed ~35 + MGN12H 54 + two 608s ~24 + shaft ~19 + sensor
                           # board and screws ~13; hardware/cad/LAYOUT.md) + moving belt ~10 + end-stop switches,
                           # carrier and cable ~5. Was a 0.40 guess until 30 Sep. Weigh the real parts (PLAN 2.2)
  travel: 0.40             # m, each way from centre: 1 m rail minus cart and end blocks (PLAN 1.2)
  coulomb_friction: 1.0    # N. guess (MGN12 clone carriage + belt), separate from the gearbox drag above
  viscous_friction: 0.5    # N·s/m. guess

pole:
  length: 0.30             # m. SPEC §7 rod 1
  mass: 0.020              # kg. 8 mm OD × 1 mm wall aluminium tube, 0.30 m ≈ 0.018 kg (PLAN 1.2)
  radius: 0.004            # m. 8 mm OD
  hub_mass: 0.010          # kg. clamp hub at the pivot (PLAN 1.2); rides with the cart
  pivot_damping: 2.0e-4    # N·m·s/rad. guess (two 608 bearings); fitted from free swing in Phase 4
  pivot_coulomb: 0.0       # N·m. dry friction at joint 1 (e.g. a slip ring's brush drag). 0 = bearings only
  cable_stiffness: 0.0     # N·m/rad. twist spring of the joint-2 cable looped across joint 1 (relaxed when hanging)

sim:
  timestep: 0.001          # s. physics step (PLAN 1.2)
  control_delay: 0.002     # s. sensing-to-actuation delay (PLAN 1.3 default)

sensing:                   # what the Pico will actually see (SPEC §9)
  cart_counts_per_rev: 403.2   # 64 CPR motor encoder × 6.3 gearbox, counted at the output shaft (datasheet)
  angle_bits: 14               # AS5047P: 16384 counts per turn = 0.022° (SPEC §6)
  angle_noise_deg: 0.0         # std-dev; replaced by the measured value from PLAN 2.4
  velocity_filter_hz: 100.0    # velocities = finite difference, then a first-order low-pass at this cutoff
  joint2_delay: 0.0            # s. extra lag on the joint-2 reading only (e.g. a wireless link); 0 = wired

joint2:                    # double only: the joint at the top of rod 1 (SPEC §7)
  mass: 0.020              # kg. guess: two small bearings + AS5047P board + printed housing + short shaft
  damping: 1.0e-4          # N·m·s/rad. guess (small bearings)
  coulomb: 0.0             # N·m. dry friction at joint 2

pole2:                     # double only: the top rod, carbon fibre tube (SPEC §6 item 21)
  length: 0.20             # m. decided by SPEC §11 Q5
  mass: 0.015              # kg. ~8 mm carbon tube (PLAN 1.6 Q5)
  radius: 0.004            # m
