olliebuckthorpe/inverted-pendulum/(commit log)

2026-09-24 docs(spec): end-stops switch a relay coil; PSU sized by the sim
    Micro switches have no usable DC power rating (Omron V-15: 0.6 A at 125 V DC),
    so the end-stops now drop an automotive relay instead of breaking motor current.
    The GST60A12 hiccups at 105-150% load while swing-up can pull 5.5-10 A, so the
    sim logs supply current (new Q6) and the PSU is ordered with the motor.
2026-09-24 feat(sim): cart-pole MJCF built from params.yaml, with physics checks (PLAN 1.2)
    Motor lives in the MuJoCo actuator (gain + back-EMF bias) so linearisation includes it.
    Rotor inertia is modelled as reflected cart mass (J*N^2/r^2 ~ 2.9 kg on 20T) instead of
    the plan's placeholder 0, which would make the sim badly optimistic.
2026-09-24 feat(sim): datasheet DC motor model, supply current + PSU cap, sensor/delay plant (PLAN 1.3)
2026-09-24 fix(sim): watch.sh wrapper so mjpython finds uv's libpython
    [watch.py]
2026-09-24 feat(sim): Q2 pulley comparison with motor-margin and supply-current checks
2026-09-24 feat(sim): Q3 rod length, Q4 loop rate, all double layouts planned; results draft
2026-09-24 docs(spec): 30T pulley chosen; attempt double swing-up on hardware behind the existing gates
    Sim robustness check: the double swing-up tolerates cart mass ±20%, friction x2 and a 4 ms delay, but fails at
    joint-2 mass ±25%, top-rod mass +20%, pivot friction x5 and 0.05 deg angle noise, so the hardware attempt needs
    measured masses, a state estimator and a low-friction slip ring or wireless sensor.
    [double_control.py, params.yaml]
2026-09-24 test(sim): reversal-current check is pulley-agnostic (fixes red suite after the 30T default)
2026-09-24 docs(sim): sensor adequacy vs AS5047P datasheet noise; PLAN 2.4 measures averaging
2026-09-24 feat(sim): Kalman filter for the double swing-up (works at AS5047P datasheet noise); robustness + Monte Carlo tools
    [double_control.py, double_montecarlo.py, double_robustness.py, double_trajopt.py, hard_eval.py, plan_variant.py]
2026-09-24 feat(sim): double swing-up robust to datasheet sensor noise and post-sysid model error
    Kalman filter fixes sensor noise (0/10 -> 10/10 at 0.068 deg). A gentle plan (duty 0.6, +-300 mm) that
    assumes 1.5x joint-2 friction swings up on 50/50 random rigs at post-sysid errors (48/50 at 2x). Slip ring
    must have <= 2 mN.m drag; a wireless joint-2 link must be <= 6 ms late. Spec and plan updated.
    [double_control.py, model.py, params.yaml, watch.py]
2026-09-24 docs(spec): joint-2 wiring crosses joint 1 as a flexible cable loop, not a slip ring
    Rod 1 stays within half a turn of hanging during the double swing-up, so no continuous rotation is needed.
    SenRing capsule slip rings are specified at 0.05 N.m, ~25x the 2 mN.m the sim tolerates. The cable must twist
    at <= 0.5 mN.m/rad (bench test 2.5b); firmware cuts the motor beyond +-1 rod-1 turn.
2026-09-24 feat(sim): transitions between all four double-pendulum resting positions (DD/UU/UD/DU)
    All 12 transitions planned (duty 0.6, +-300 mm, friction margin, cable limit) and flown with TVLQR + Kalman
    filter: 5/5 nominal, 17-20/20 on random post-sysid rigs. Tours DD-UU-UD-DU-DD work 10/10. Joint 2 must hold
    rod 2 beside rod 1 so it can swing past.
2026-09-25 feat(ai): SAC training environment mirroring the Pico loop, with domain randomisation incl. backlash; clip index
    Env: 500 Hz control with delay, quantised sensors, 5 A limiter; policy at 100 Hz with action smoothing.
    Every episode randomises masses, rod length, motor constants, rotor inertia, frictions, delay, gearbox play,
    belt stretch and sensor noise. LQR through the env balances 20/20. One torch thread is fastest (490 steps/s).
    Training snapshots feed a timelapse video. media/CLIPS.md indexes every clip.
    [ai_progress.py, ai_timelapse.py, train_ai.py]
2026-09-25 feat(ai): animate the policy network wiring itself up during training (from snapshots, incl. step 0)
2026-09-25 docs(hardware): PLAN 2.1 electronics: power path, pin map, braking-energy and logic-level decisions
    MD13S: logic HIGH >= 3.0 V, PWM <= 20 kHz, PWM LOW brakes. RP2350 guarantees only 2.62 V HIGH, so measure
    before motor power. GST60A12 OVP latches at 12.6-16.2 V; sim regen bursts ~0.16 J, so a Schottky diode +
    2200 uF + TVS keeps energy off the PSU (bus ~17.8 V peak). End-stops sensed via dividers; encoder on VBUS
    with 1 k series resistors (RP2350 digital pins are 5.5 V tolerant when powered).
2026-09-25 feat(cad): parametric cart, belt clamp, sensor bracket, magnet cap and rod hub (PLAN 2.2, v1)
    Desk-edge beam layout: rail on the beam's front face, rod swinging in the rig's frontmost plane, motor and
    idler behind it. MGN12H dimensions from the HIWIN catalogue (M3 x 3.5 threads limit screw length). Sensor
    behind the plate on posts; magnet held 3 mm off the steel shaft. Shaft cut to 49 mm. Cart ~145 g vs the
    sim's 400 g assumption.
    [belt_clamp.step, belt_clamp.stl, cart.step, cart.stl, magnet_cap.step, magnet_cap.stl, rod_hub.step, rod_hub.stl]
2026-09-25 fix(ai): timelapse caption glyph; reward/rate variants after balance drifted off the rail (8-16/100)
    [ai_timelapse.py, train_ai.py]
2026-09-25 feat(ai): curriculum training (easy stage, then full randomised rig)
    Balance learned from scratch on the full rig failed twice (1/100, 8-16/100; reward variants 0-14/100): the
    cart drifted into the rail even on the nominal rig. The sanity-check policy trained on the easy setup (fixed
    rig, rigid drive, no smoothing, no noise) passes 99/100 on fully randomised rigs, so the fix is a curriculum.
    [train_ai.py]
2026-09-25 feat(ai): train without sensor noise, always evaluate with it
    Ablation: +random physics 100/100, +gearbox/belt 100/100, +smoothing 100/100, +noise only 36/100,
    +physics & noise 1/100. A model-free Kalman estimator only trades noise for lag (no better than the existing
    differencing + low-pass), so noise is removed from training and robustness to it is proven in evaluation.
    [train_ai.py]
2026-09-25 feat(ai): AI meets PLAN 5.3 targets in the datasheet sim (balance 99/98, swing-up + hand-over 93% hold-out)
    Balance: train on the full rig with sensor noise off, test with it. Hand-over: balance policy trained from
    the states the swing-up actually hands over in. Evaluation now always uses the full rig. RESULTS-ai.md
    records every attempt, including the failures and the seed sensitivity.
    [ai_demo.py, ai_handover.py, reevaluate_all.py, train_ai.py]
2026-09-25 fix(ai): video scripts parse the task from variant tags (balanceG_seed0 etc.); caption says realistic sim
    [ai_network_anim.py, ai_timelapse.py]
2026-09-25 feat(ai): fair multi-seed selection; chosen AI controller scores 96% on hold-out rigs
    swingupE_seed3 -> balanceGc_seed4 at 15 deg, chosen on 100 validation rigs from 80 combinations (median 42),
    then scored once on 200 hold-out rigs: 96.0% varied noise, 96.5% at datasheet noise.
    [ai_demo.py, select_ai.py]
2026-09-25 fix(safety): brake relay in the motor lead instead of a supply cut-off
    Sim: cutting power lets the cart coast 720-840 mm from 1.6 m/s (into the rail end); shorting the motor stops it
    in 100-118 mm. A 5-pin changeover relay connects the motor to the driver when energised and shorts it when the
    E-stop, an end-stop or power loss drops it. End-stops move to +-350 mm; TPU bumpers at the rail ends.
2026-09-25 feat(cad): motor and idler end blocks, cart-mounted end-stops with ramps, TPU bumpers; clearance checker
    Pololu 37D mount from its dimension drawing (Ø31 bolt circle, 7 mm shaft offset, 3.0 mm thread limit).
    End-stops ride on the cart and are pushed by ramps so they stay pressed while the brake relay stops the
    cart (a head-on switch would be crushed). clearance.py: 0 collisions across cart positions and rod poses;
    first trip at about +-348 mm, released at +-325.
    [belt_clamp.step, bumper_left.step, bumper_left.stl, bumper_right.step, bumper_right.stl, cart.step, end_ramp_left.step, end_ramp_left.stl]
2026-09-25 feat(firmware): policy network inference in plain C++ for the Pico, exported from SAC (PLAN 6.1)
    mlp_policy.h runs the SAC actor's deterministic path (6->64->64->1, ReLU, tanh). export_policy.py writes the
    4673 weights as an uploadable .bin and a compiled-in .h. On 1,000 realistic-sim observations the C++ matches
    PyTorch to 5.4e-7 (limit 1e-4), both weight paths; mutation-checked.
2026-09-25 feat(firmware): Mac<->Pico protocol (COBS + CRC-16), C++ and Python, cross-tested byte for byte (PLAN 2.5)
2026-09-25 feat(firmware): portable control core (estimator, supply limiter, classical, AI hand-over, safety) with parity tests
    The Pico's control logic mirrors the Python that produced the sim results, verified step by step on recorded
    runs (estimator, classical incl. hand-over edge cases, AI actions to 1.9e-6, supply limiter) and with safety
    unit tests (heartbeat latch, speed-aware soft limit, fall, clamp, slew). All mutation-checked. Slew limit
    0.25/cycle chosen from sim: classical 10/10 and AI 97/100 unaffected (0.1 would cost the AI).
2026-09-25 feat(firmware): Pico 2 sketch (core-1 fixed-rate loop, core-0 USB), drivers, Mac set-up/latency/PlotJuggler tools
    Compiles for rp2040:rp2040:rpipico2 with -Wall clean (65 kB flash, 53.5 kB RAM). AS5047P over SPI mode 1 with
    the datasheet's next-frame reply, parity and error-flag checks; motor encoder via Raspberry Pi's PIO quadrature
    program (.origin 0); MD13S PWM at 20 kHz; watchdog; PARAM/WEIGHTS/PING/KICK handling. pico_setup.py sends every
    parameter from params.yaml and the designed controllers; a test checks the firmware handles each one.
    [params.h, pendulum.ino, pico_setup.py, telemetry_bridge.py, usb_latency.py]
2026-09-25 feat(tests): draft test-protocol numbers from the sim, both controllers through one pipeline (PLAN 5.4)
    Software kicks now override the duty (an additive kick was mostly cancelled by the controller); a push counts as
    survived only if the rod never passes the 35 deg hand-back angle. Draft: 5 s time limit, 5 s hold, +-2.7 deg
    settle band, 40 ms standard kick, 20-120 ms ladder in 10 ms steps. Final numbers after the fitted sim.
2026-09-30 Record the parts as ordered and update the design for the substitutions (#6)
    - hardware/orders.md: every order (TME, RS, Gears & Sprockets, Amazon, The Pi Hut) with part numbers and
    prices, what's still to buy in person, and checks on arrival.
    - MDD10A replaces the MD13S (unobtainable in time): same PWM/DIR interface, logic levels, 20 kHz limit and
    truth table (manual v1.1); wiring doc, SPEC and firmware comments updated. Check the board is REV2.0.
    - 1.5KE20A TVS, 1N4001 flyback: margins re-checked against the 17.8 V sim peak and the 12 V coil.
    - Pico 2 W ordered: firmware still builds for the plain Pico 2 so the wireless chip stays unpowered
    (the rpipico2w target starts it at boot: PI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
    [clone_motor_double.py, clone_motor_replan.py, clone_motor_single.py, control.h, pendulum.ino]
2026-09-30 Bench bring-up kit: staged guide, a Mac command per check, and the safety checklist (#7)
    - hardware/BRINGUP.md: parcels to a safe rig in 7 stages, one new thing proven before the next gets power.
    - sim/bringup.py: watch, calibrate (theta zero -> hardware/rig-calibration.json, also used by pico_setup),
    noise (2.4), ruler (3.3), loop (2.6), spin, levels (>= 3.0 V at the MDD10A, motor disconnected),
    hang (hardware watchdog) and fallcheck (balance mode with the rod hanging must fault, no motion).
    - hardware/safety-checklist.md: the PLAN 3.4 items with how-to-test and pass criteria.
    - Firmware: telemetry bits 12-15 carry the live E-stop/end-stop/angle-read levels in every mode (bench
    diagno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
    [blink_w.ino, bringup.py, link.py, pendulum.ino, pico_setup.py]
2026-09-30 System ID tools for Phase 4: record, fit, validate, rehearse (#8)
    - sim/sysid.py: records the five cart tests (SYSID mode) and free swings, fits the sim (pendulum: effective
    length, pivot damping and dry friction; cart: Kt, Ke, dry and viscous friction, delay searched per 1 ms),
    applies the PLAN 4.3 checks and draws sim-vs-real overlays; --write updates params.yaml.
    - rehearse: the whole pipeline on synthetic recordings of a deliberately different rig. Result: delay exact,
    rod length and damping exact, the per-kg motor/drag/friction ratios within 0.5 %, all 4.3 checks pass.
    - The recordings pin ratios to the moving mass, not Kt/R/rotor inertia separately (an earlier rehearsal fitting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
2026-10-01 Cart mass 0.40 -> 0.16 kg (CAD + belt + switches) and every sim decision re-checked (#9)
    The 0.40 kg was a guess; the CAD puts the cart at ~145 g, plus the moving belt and the end-stop parts.
    Re-run on 0.16 kg: single swing-up 20/20; 30T still beats 20T (+24 % tap); 30 cm rod and 500 Hz stand; the
    double swing-up re-planned (2.09 s) flies 50/50 at post-sysid errors x0.5/x1/x1.5 (was 50/50/48); all 12
    transitions re-planned, same success (11 x 20/20, DU->UU 17/20). Trajectories re-saved for the new mass.
    [params.yaml]
2026-10-01 AI double balance in sim (97–100/100 realistic); swing-up experiment in progress (#10)
    * AI double balance in sim: 97/100 and 100/100 on realistic rigs
    Double environment (envs/double_env.py: the double's sensing, delay, limiter, smoothing, randomisation) and
    trainer (train_double.py). Balance failed at 200 Hz decisions even on one fixed rig (0-1/50), though LQR
    balances the same env 20/20 at 50 Hz; at 50 Hz it learns (87/75 easy, 97-99 random physics) but sensor noise
    breaks it (4-27) because differenced velocities are too poor at 50 Hz (LQR: 0/20). Giving the policy the
    classical double's Kalman-filtered state: 97 and 100/100 on unseen realistic rigs. Swing-up (exploratory)
    still traini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
    [double_balanceEb50_seed0.monitor.csv, double_balanceEb50_seed1.monitor.csv, double_balanceEb_seed0.monitor.csv, double_balanceEb_seed1.monitor.csv, double_balanceG50_seed0.monitor.csv, double_balanceG50_seed1.monitor.csv, double_balanceG50_seed2.monitor.csv, double_balanceG50k_seed0.monitor.csv]
2026-10-01 Orders: DigiKey replaces the RS order that never completed (#11)
    The 29 Sep RS checkout never went through. On re-ordering, RS had the AS5047P kit out of stock until
    1 Dec (after the deadline); Farnell lists it no longer manufactured, Mouser had none, DigiKey had 392 left.
    Ordered from DigiKey on 1 Oct: Mean Well (cheaper than RS), 3 x AS5047P (1 spare: discontinued),
    MBR1045G, 2 x 2200 uF, 1.5KE22A (the design's original TVS), 3 x 1N4001, resistors; free delivery over
    GBP 65 ex VAT. Docs back to the 1.5KE22A; spend recorded against the target.
2026-10-05 AI double swing-up (exploratory): works on 68 % of realistic rigs, not dependable (#12)
    Swing-up -> hand-over -> balance from hanging: 34/50 realistic rigs with the best snapshot, but 0/30 on the
    nominal rig and 8/30 on random rigs without noise (it circles just outside the catch zone; variation tips it
    in). The classical swing-up stays the hardware plan.
    What it took: a height reward taught it to spin the rods (now illegal: rod 1 limited to +/-1 turn for the
    joint-2 cable); a per-rod box zone was mostly uncatchable, so the zone is the balance LQR's cost-to-go
    V < 250 (95 % caught); arrival-only and guided zone rewards reached it 0-28 %; a reverse curriculum along the
    classical plan's state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
    [double_balanceG50k_seed2.monitor.csv, double_balanceG50kc_seed0.monitor.csv, double_balanceG50kc_seed1.monitor.csv, double_swingupE_seed0.monitor.csv, double_swingupE_seed1.monitor.csv, double_swingupE_seed2.monitor.csv, double_swingupEc_seed0.monitor.csv, double_swingupEc_seed1.monitor.csv]
2026-10-05 CAD: bearing and shaft fit-test print (#13)
    * CAD: bearing and shaft fit-test print (print this first)
    Three 608 seats and three 8 mm bores at 0.10/0.15/0.20 mm radial clearance, marked with 1/2/3 notches, so
    P.fit is set from this printer before the cart, rod hub and magnet cap are printed. ~14 g.
    * CAD: bearing fit 0.10 mm from the fit test; shaft fit split out
    fit_test on the Bambu A1 in PLA: seat 1 (0.10 mm radial) is a firm press fit, 2 and 3 looser. P.fit = 0.10
    for the 608 seats (and the magnet pocket). The shaft's clearance is now its own parameter (shaft_fit, 0.05
    until the shaft is tried in the test's bores). Re-exported cart, rod hub and magnet cap; clearance.py: 0
    collisions.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
    [cart.step, cart.stl, fit_test.step, fit_test.stl, magnet_cap.step, magnet_cap.stl, rod_hub.step, rod_hub.stl]
2026-10-05 Handoff to the Windows PC for the hardware work (#14)
    The Pico 2 W can't plug into the Mac, so bring-up continues on the Windows PC with Claude Code there.
    HANDOFF.md: setup commands, where everything stands, next steps, Ollie's rules. PLAN 2.3 done (blink via UF2
    from Windows). Windows fixes: build.sh passes a C:/ include path under Git Bash; bringup.py prints UTF-8.
    [bringup.py]
2026-10-05 CAD: shaft fits from the fit test (#15)
    The 8 mm shaft only just entered the 0.075 and 0.10 mm test bores (the A1 prints 8 mm holes small). Rod hub
    (slides on, pinch screws grip) and its 8 mm tube socket: 0.15 mm; magnet cap (push-fit): 0.10 mm. Re-exported
    both; clearance.py 0 collisions.
    [magnet_cap.step, magnet_cap.stl, rod_hub.step, rod_hub.stl]
2026-10-05 CAD: cart prints without support in its bearing seats
    Printed standing on the bearing boss (the only way both seats come out round), the front seat's flat inner
    step overhung and the slicer filled the seat with support. It's now a 45-degree cone that prints itself; the
    bearing stops at the same depth. cart_print.stl is the cart already in that orientation (boss face on the
    bed). clearance.py: 0 collisions.
    [cart.step, cart.stl, cart_print.step, cart_print.stl]
